lehangajanayake/formguard-booth/README.md

<p align="center">
  FormGuard
</p>

# FormGuard booth demo

FormGuard helps lifters understand their lifting form. Small motion sensors strapped to the arm stream to a web app that shows movement in 3D and surfaces elbow motion during bicep curls.

The standalone project site is in [`site/`](site/). [Watch the demo](https://formguard-booth-demo-report.vercel.app) to see the recorded booth sessions, hardware overview and custom sensor enclosure. The live sensor app remains in [`frontend/`](frontend/).

The booth videos are in `site/media/` as `clean-curl.mp4` and `elbow-swing.mp4`; the project page synchronizes them with the clean curl and swinging arm sensor recordings. Session recordings under `data/` are included in `site/recordings/` for replay and downloads.

To recalculate the video-to-sensor alignment, install `analysis/requirements.txt` with `uv pip install --python analysis/.venv/bin/python -r analysis/requirements.txt`, then run `analysis/.venv/bin/python analysis/sync_video_pose.py`. YOLO pose detection finds the clean clip's calibration gesture and curl cycles; clean playback starts at the third curl, aligned with the first sample in that recording. YOLO weights are cached outside the repository.

<p align="center">
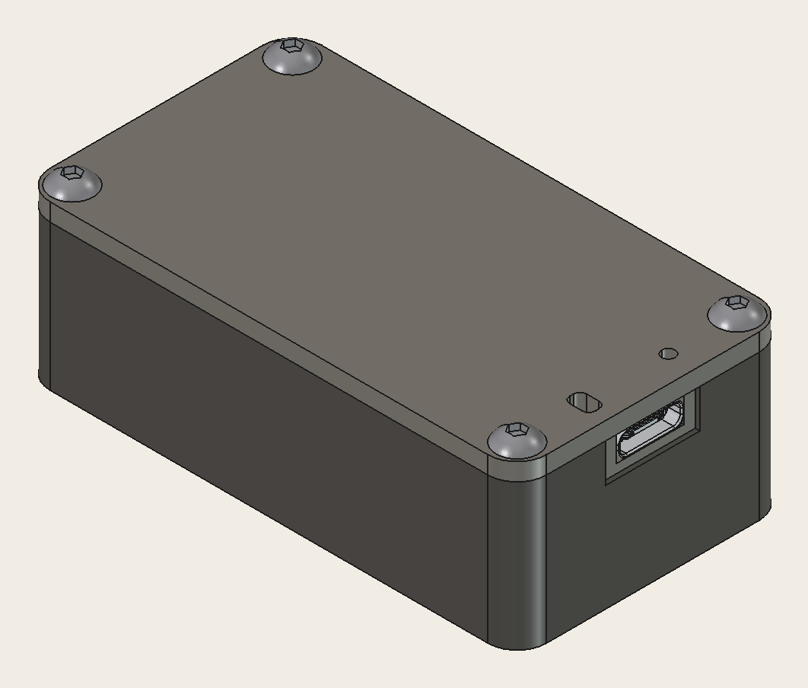
[picture p1: 3d-case/images/case_assembled.png]
The sensor case, assembled, with the USB-C port at the front
  
</p>

## How it works

1. Each sensor is a **Seeed XIAO nRF52840 Sense** with a 400 mAh LiPo, in a 3D-printed case. Its 6-axis IMU (LSM6DS3, accelerometer and gyro) feeds an orientation filter on the board at about 100 Hz.
2. The board sends its orientation over **Bluetooth LE**, as a quaternion, at about 50 Hz.
3. The **web app** connects with Web Bluetooth and turns those orientations into joint angles. It shows them on a 3D arm.

The app supports three sensor setups:

| Setup | Boards | What it measures |
| --- | --- | --- |
| Forearm only | 1 | Elbow angle and forearm twist |
| Wrist only | 1, worn like a watch | Elbow angle and forearm twist |
| Upper arm + forearm | 2 | Elbow angle, forearm twist and where the elbow drifts to |

## Repo layout

| Folder | What's in it |
| --- | --- |
| [`embedded/`](embedded) | Sensor firmware (PlatformIO, Arduino). Orientation filter, BLE service, calibrate and sleep commands, battery level |
| [`frontend/`](frontend) | Web app (Vite, three.js, Web Bluetooth) and the FormGuard design system |
| [`3d-case/`](3d-case) | The sensor case: FreeCAD script, print files and reference models |

## Getting started

### Flash the sensors

Install [PlatformIO](https://platformio.org/). Then, from `embedded/`:

```bash
pio run -e imu -t upload         # forearm or wrist board, advertises as FormGuard-Fore
pio run -e imu-upper -t upload   # upper arm board, advertises as FormGuard-Upper
```

### Run the web app

```bash
cd frontend
npm install
npm run dev
```

Open the address Vite prints to use the live sensor app. Web Bluetooth isn't supported in Safari or Firefox. Pick a sensor setup, strap the boards on as the app shows, and hold the calibration pose: arm hanging straight, palm facing your thigh.

### Build the static website

The project site is plain static HTML, CSS and JavaScript. Serve or deploy the contents of `site/` as a static website. Keep its `assets/`, `recordings/` and `media/` folders alongside `index.html`.

### Battery and sleep

Each board reports its battery over BLE: voltage, an estimated percentage for the 400 mAh LiPo, and whether it is charging over USB-C. The app shows it as a battery icon with the percentage inside. The Calibrate page shows it next to each sensor. The Live page shows it too, and warns at 20% or below, where the icon turns red.

**Sleep** (on the Calibrate page) or **Sleep sensors** (on the Live page) switches a board off, except the accelerometer. **Double-tap the board** to wake it, then press Connect. RESET also restarts a sleeping board, and double-pressing RESET still enters the UF2 bootloader for flashing.

## The sensor case

<p align="center">
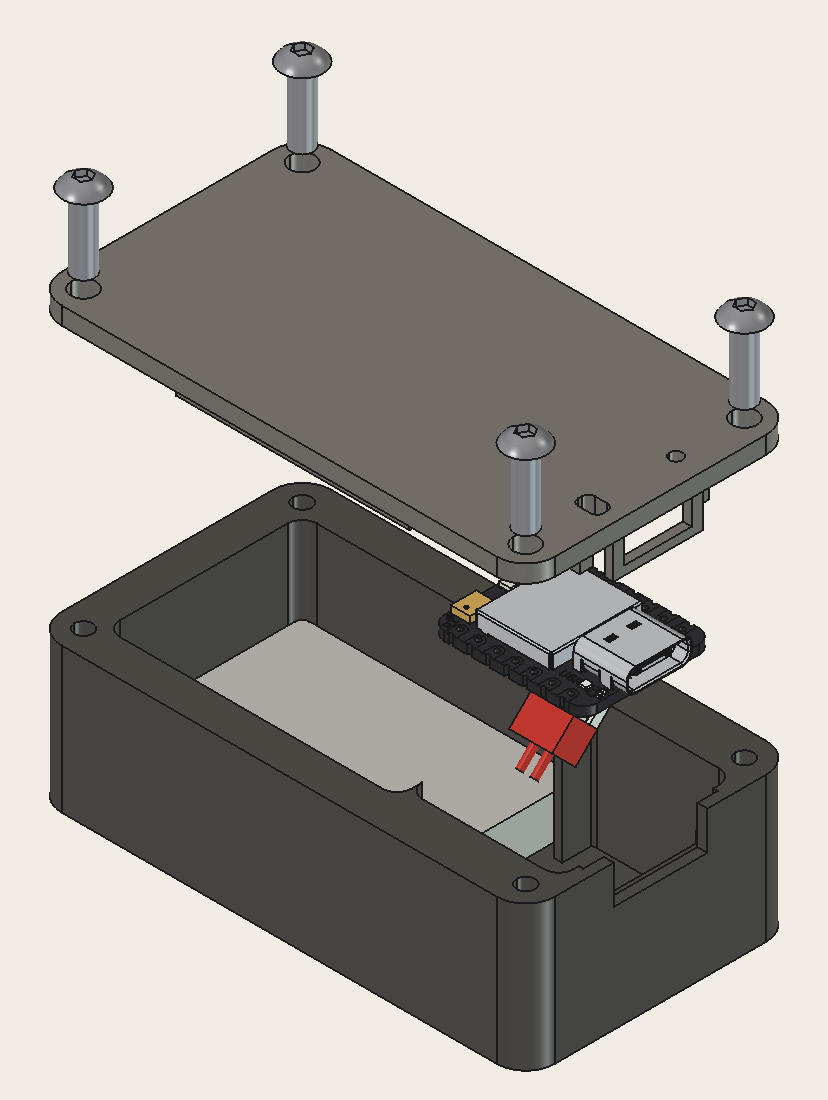
[picture p2: 3d-case/images/case_exploded.png]
Exploded view: base with the battery, board with the battery plug, lid and four screws
  
</p>

Two printed parts, a base and a lid, held together by four standard M3 × 10 screws, with no inserts or nuts. The outside is **67.7 × 37 × 22.3 mm**.

- **Battery beside the board.** The LiPo lies on the floor at the far end from the USB-C, clear of the board. Two ribs on the lid hold it down. The board's battery socket hangs into a pit underneath the board.
- **USB-C reachable from outside.** You can charge and flash without opening the case.
- **LED window and reset hole** in the lid.
- **Board clips into the lid.** The USB-C hooks into a cradle as a hinge, and a flexible latch clicks over the far end. No tape or tools, and it comes out the same way. With the lid on, the board's corners rest on four fins in the base.

<p align="center">
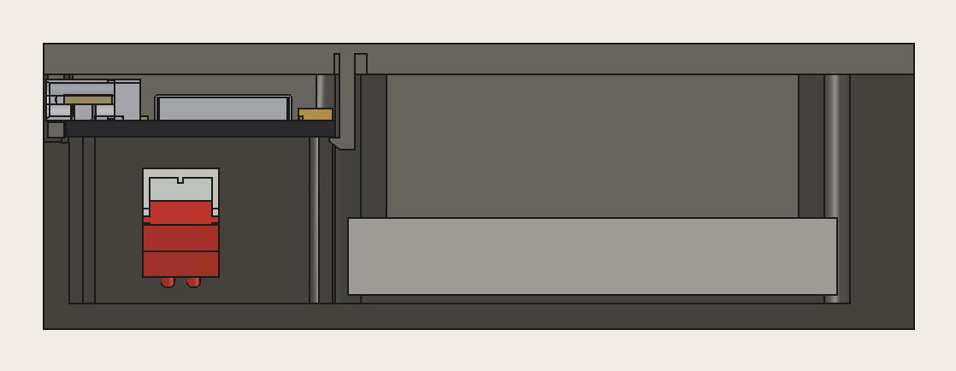
[picture p3: 3d-case/images/case_section.png]
Cut-away: the board under the lid, the battery socket and plug in the pit below it, and the battery beside it
  
</p>

<p align="center">
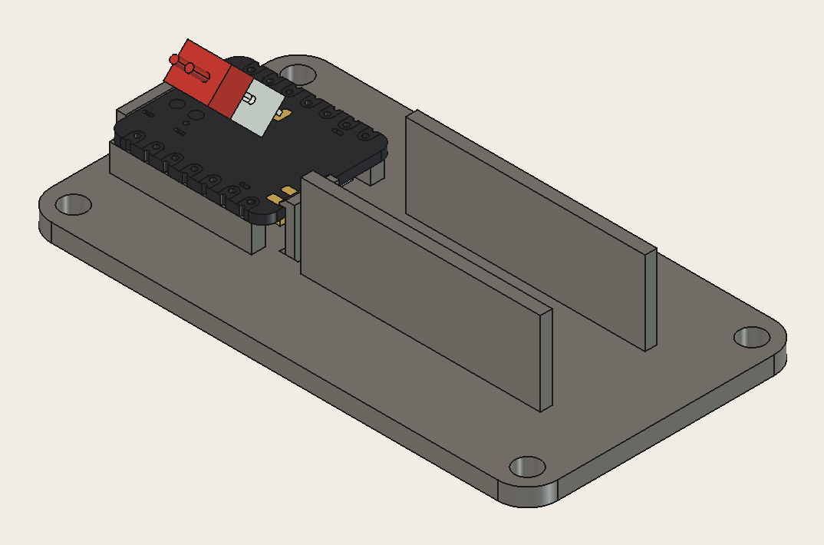
[picture p4: 3d-case/images/case_lid_board.png]
The lid upside down with the board clipped in
  
</p>

Print it in PETG. The lid's latch has to flex, and PLA may crack after many clicks. A PrusaSlicer project for the MK4S is in `3d-case/print-package/` and takes about 1 h 24 min and 28 g for the set, with no supports.

Dimensions, assembly, print settings and how to change the design are in [`3d-case/README.md`](3d-case/README.md).
