lehangajanayake/formguard-booth/3d-case/prompt.md

I want a case for seeed xio nrf 52 with a battery that will be soldered to it the inforamtion about the battery can be found on https://core-electronics.com.au/polymer-lithium-ion-battery-400mah-38456.html

I have no idea how to mount it since ethere are no cutouts for any screws as far as im aware, therefore u have creatice choise over it, I need a cutout to view the in built LED I should be able to get the board out to the casing when needed

Im using a 3rd party service to get this done, id like screws but only use standard screws if any,
