lehangajanayake/formguard-booth/frontend/FormGuard-design-system/previews/components.png

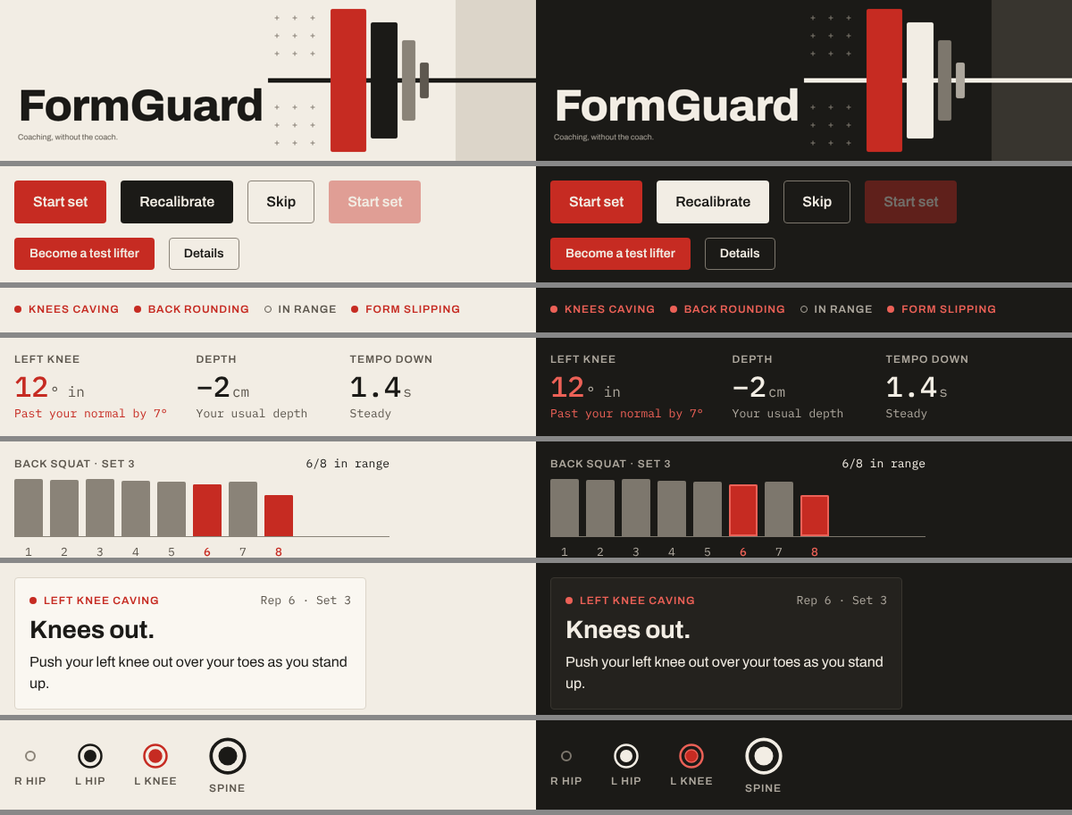
frontend/FormGuard-design-system/previews/components.png
