lehangajanayake/formguard-booth/3d-case/output/formguard_case.FCStd

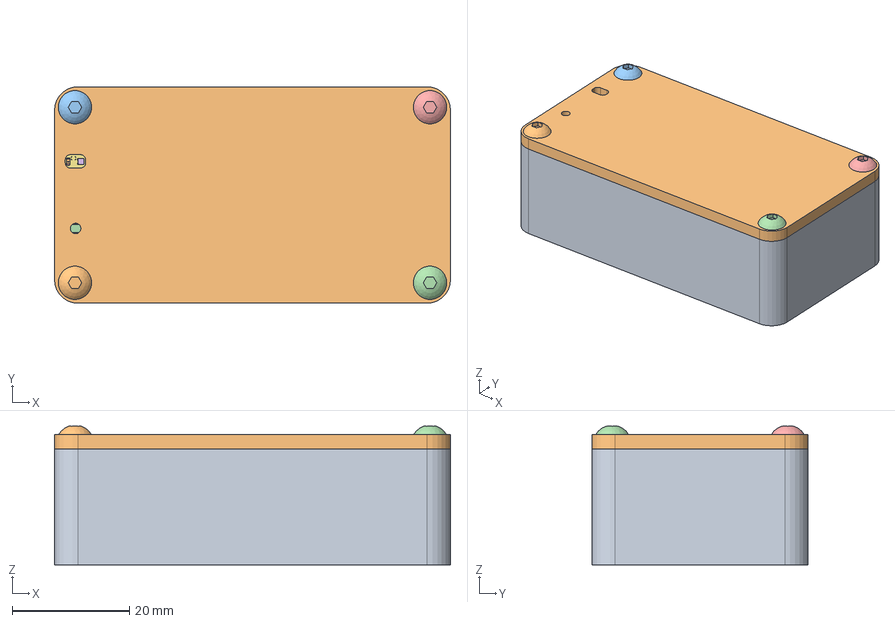
[picture p6: CAD file, 2026-10-20]
3d-case/output/formguard_case.FCStd
67.7 x 37.0 x 23.7 mm
Base
Lid
BOSS-EXTRUDE14_8_
BOSS-EXTRUDE7_4_
BOSS-EXTRUDE7_3_
BOSS-EXTRUDE14_4_
BOSS-EXTRUDE14_2_
BOSS-EXTRUDE14_11_
BOSS-EXTRUDE7_7_
BOSS-EXTRUDE14_9_
BOSS-EXTRUDE14_3_
BOSS-EXTRUDE14_7_
MIRROR2
BOSS-EXTRUDE14_5_
BOSS-EXTRUDE14_12_
BOSS-EXTRUDE7_8_
BOSS-EXTRUDE7_1_
BOSS-EXTRUDE14_10_
BOSS-EXTRUDE7_9_
BOSS-EXTRUDE14_6_
BOSS-EXTRUDE14_1_
BOSS-EXTRUDE7_6_
BOSS-EXTRUDE7_2_
CUT-EXTRUDE5
BOSS-EXTRUDE7_5_
Shield
Pins
Pins001
Pins002
Pins003
CAP
CAP001
CAP002
ANT1
ANT001
ANT002
Silkscreen
Silkscreen001
Silkscreen002
Silkscreen003
Silkscreen004
Silkscreen005
Silkscreen006
Silkscreen007
Silkscreen008
Silkscreen009
Silkscreen010
Silkscreen011
Silkscreen012
CAP004
CAP005
CAP006
CAP 3
CAP 001
CAP 002
LED
LED001
LED002
LED003
USR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
