lehangajanayake/formguard-booth/3d-case/print-package/formguard_base.step

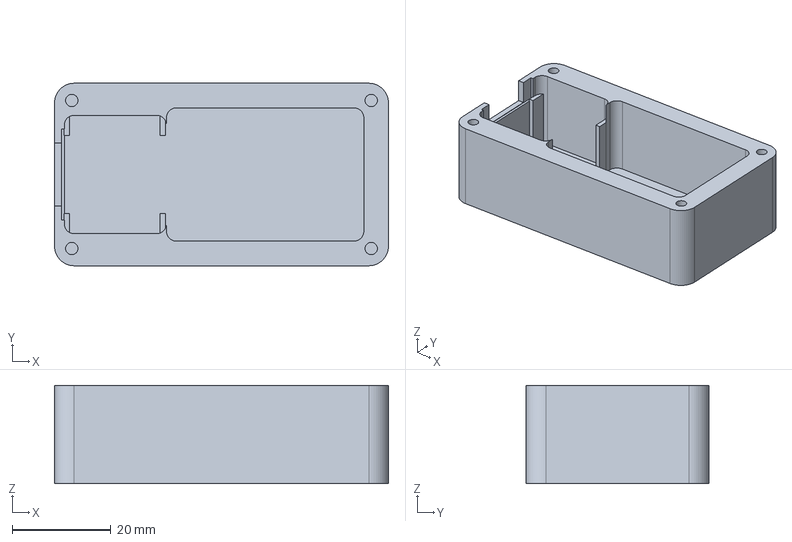
[picture p7: CAD file, 2026-10-20]
3d-case/print-package/formguard_base.step
67.7 x 37.0 x 19.9 mm
