lehangajanayake/formguard-booth/3d-case/reference/battery-400mah/battery_400mah.step

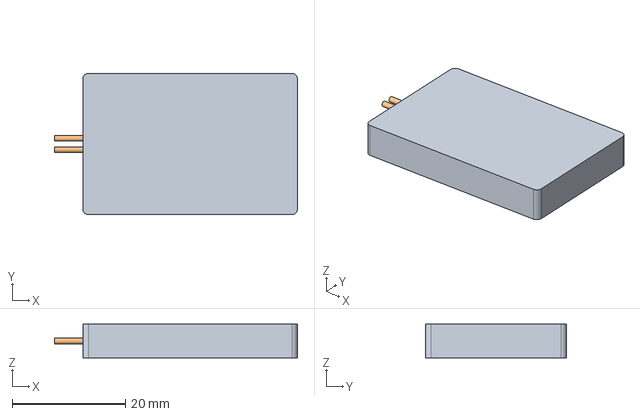
[picture p8: CAD file, 2026-10-20]
3d-case/reference/battery-400mah/battery_400mah.step
43.0 x 25.0 x 6.00 mm
