lehangajanayake/formguard-booth/3d-case/reference/jst-ph/PHR-2_mated_envelope.step

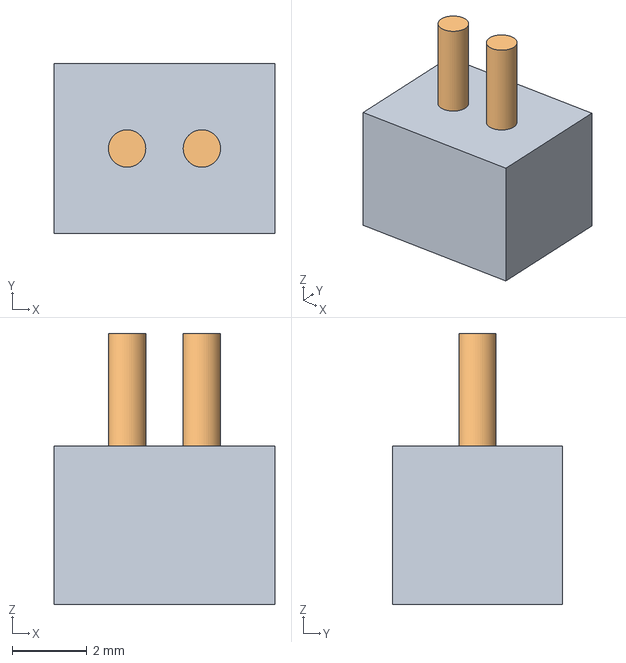
[picture p9: CAD file, 2026-10-20]
3d-case/reference/jst-ph/PHR-2_mated_envelope.step
5.90 x 4.55 x 7.24 mm
