lehangajanayake/formguard-booth/3d-case/reference/xiao-nrf52840/bottom-pad-positioning/Seeed XIAO nRF52840 v1.0 Dimensioning.dxf

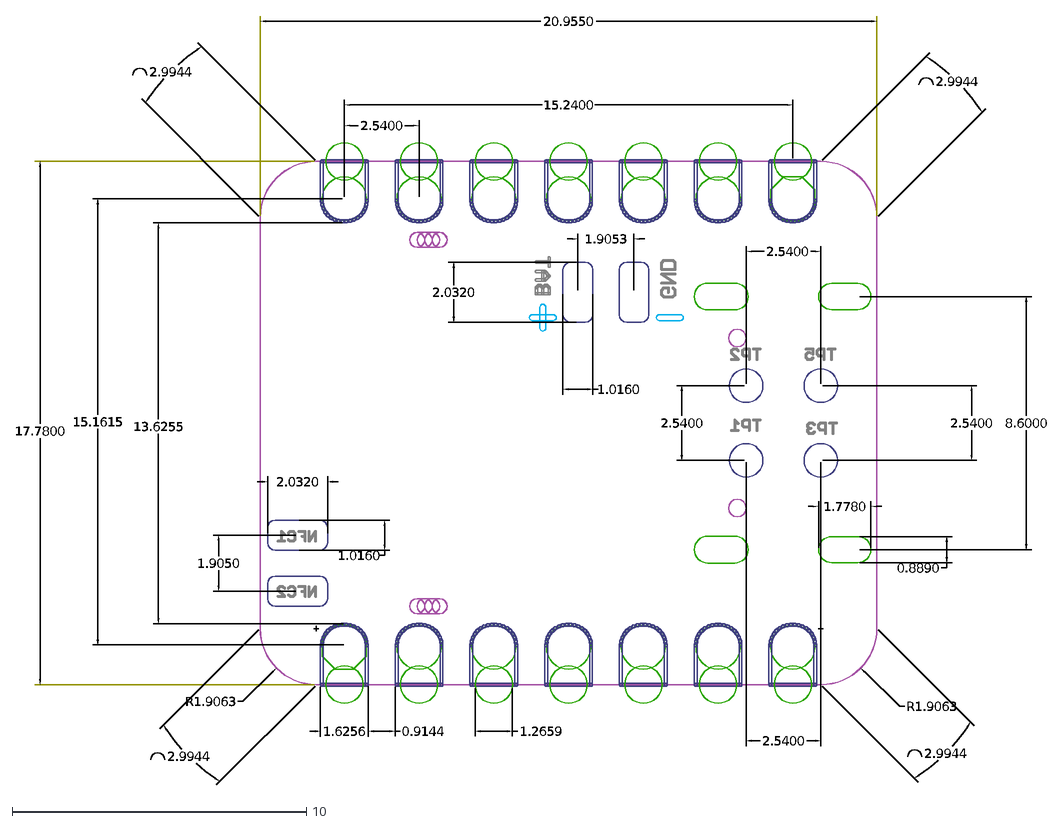
[picture p10: CAD file, 2026-10-19]
3d-case/reference/xiao-nrf52840/bottom-pad-positioning/Seeed XIAO nRF52840 v1.0 Dimensioning.dxf
20.9550
17.7800
15.2400
1.6256
2.5400
2.0320
1.0160
1.9053
1.9050
R1.9063
2.9944
0.9144
13.6255
8.6000
0.8890
1.7780
15.1615
1.2659
