lehangajanayake/formguard-booth/3d-case/output/formguard_lid.step

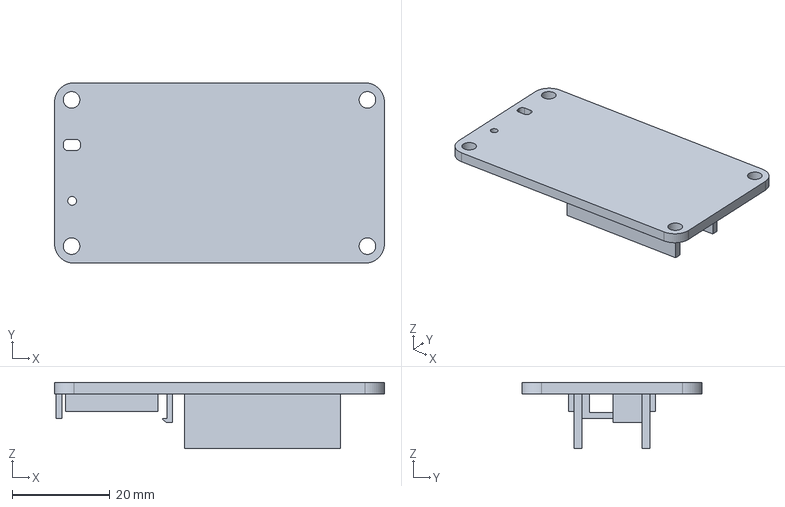
[picture p12: CAD file, 2026-10-20]
3d-case/output/formguard_lid.step
67.7 x 37.0 x 13.6 mm
