lehangajanayake/formguard-booth/3d-case/reference/jst-ph/JST_PH_B2B-PH-K_1x02_P2.00mm_Vertical.step

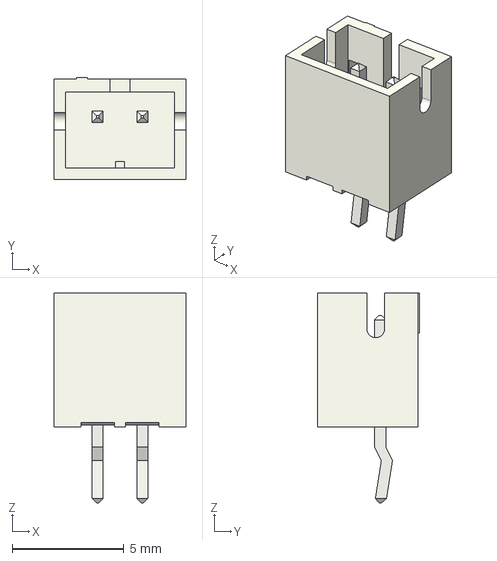
[picture p13: CAD file, 2026-10-20]
3d-case/reference/jst-ph/JST_PH_B2B-PH-K_1x02_P2.00mm_Vertical.step
5.90 x 4.55 x 9.40 mm
