lehangajanayake/formguard-booth/3d-case/reference/xiao-nrf52840/top.dxf

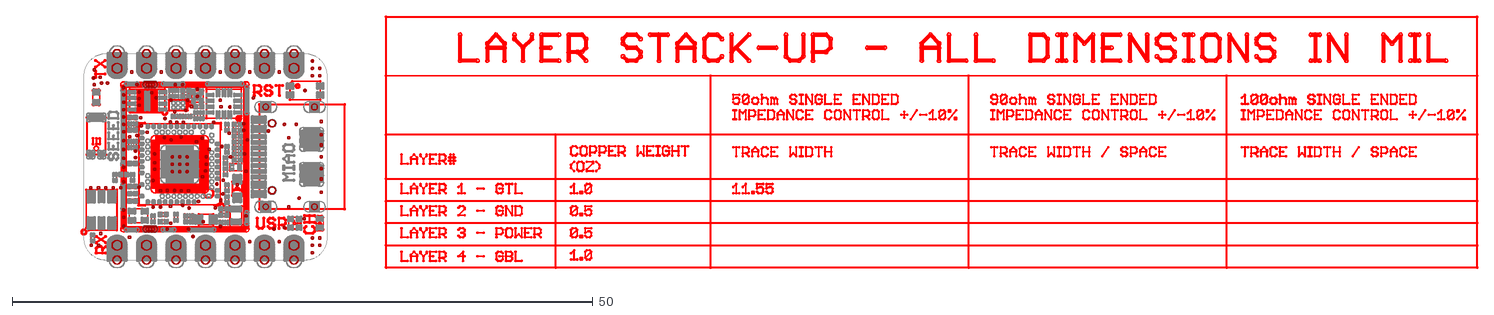
[picture p14: CAD file, 2026-10-19]
3d-case/reference/xiao-nrf52840/top.dxf
125.9 x 22.3
