lehangajanayake/formguard-booth/3d-case/print-package/formguard_case_MK4S_PETG.3mf

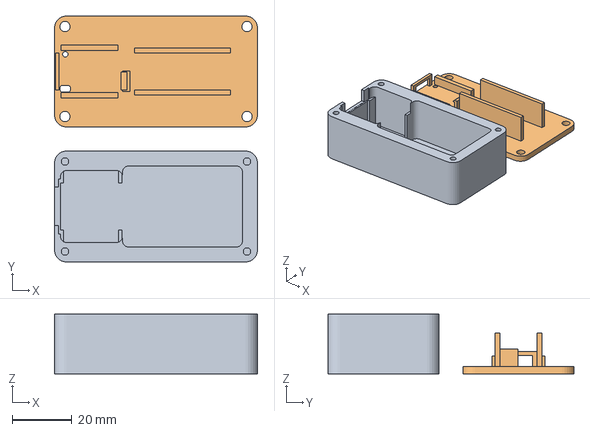
[picture p15: CAD file, 2026-10-20]
3d-case/print-package/formguard_case_MK4S_PETG.3mf
67.7 x 82.0 x 19.9 mm
base
lid
