lehangajanayake/formguard-booth/3d-case/reference/xiao-nrf52840/bottom.dxf

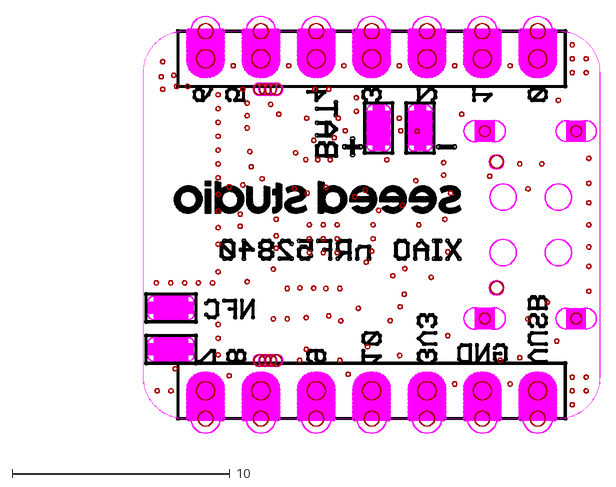
[picture p16: CAD file, 2026-10-19]
3d-case/reference/xiao-nrf52840/bottom.dxf
26.8 x 19.7
