lehangajanayake/formguard-booth/3d-case/reference/screws/ISO7380-1_M3x10.step

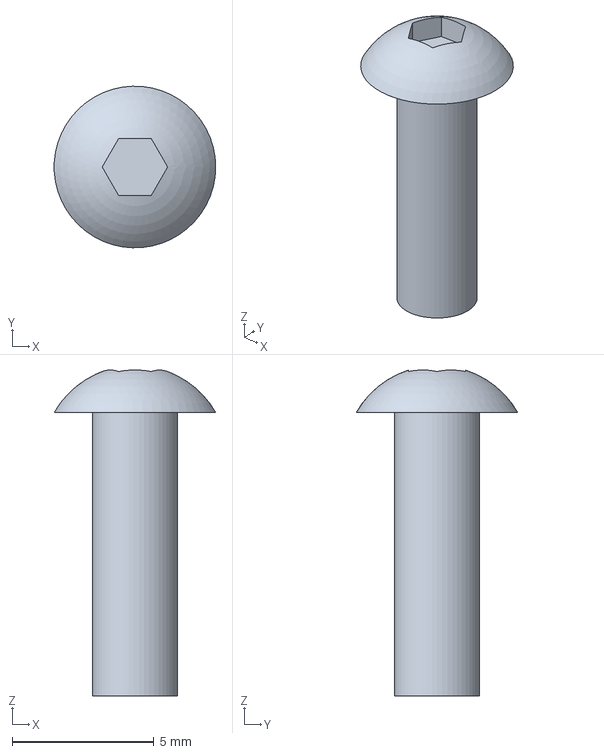
[picture p17: CAD file, 2026-10-20]
3d-case/reference/screws/ISO7380-1_M3x10.step
5.69 x 5.70 x 11.5 mm
