lehangajanayake/formguard-booth/(list of files, cad)

Other CAD files:
3d-case/output/formguard_base.stl
3d-case/output/formguard_lid.stl
3d-case/print-package/formguard_base.stl
3d-case/print-package/formguard_lid.stl
