lehangajanayake/formguard-booth/3d-case/print-package/preview_assembly.png

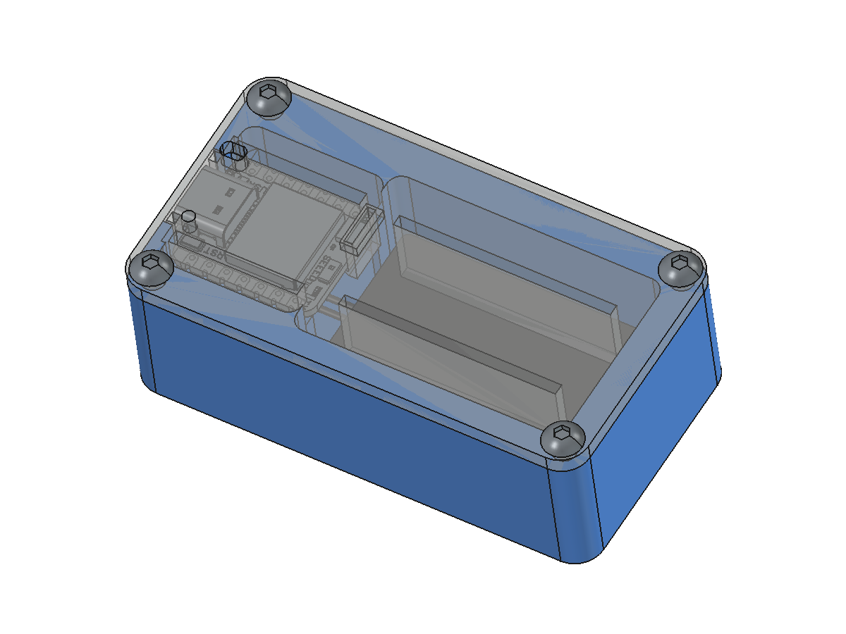
3d-case/print-package/preview_assembly.png
