lehangajanayake/formguard-booth/3d-case/print-package/preview_base.png

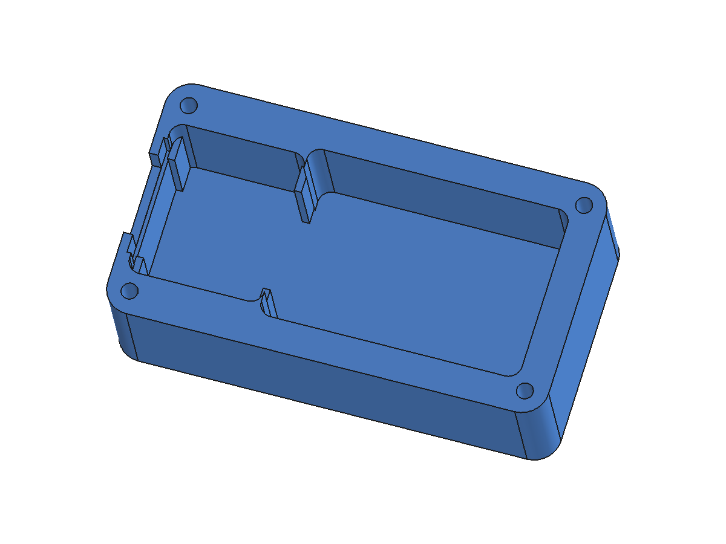
3d-case/print-package/preview_base.png
