lehangajanayake/formguard-booth/3d-case/print-package/preview_lid_underside.png

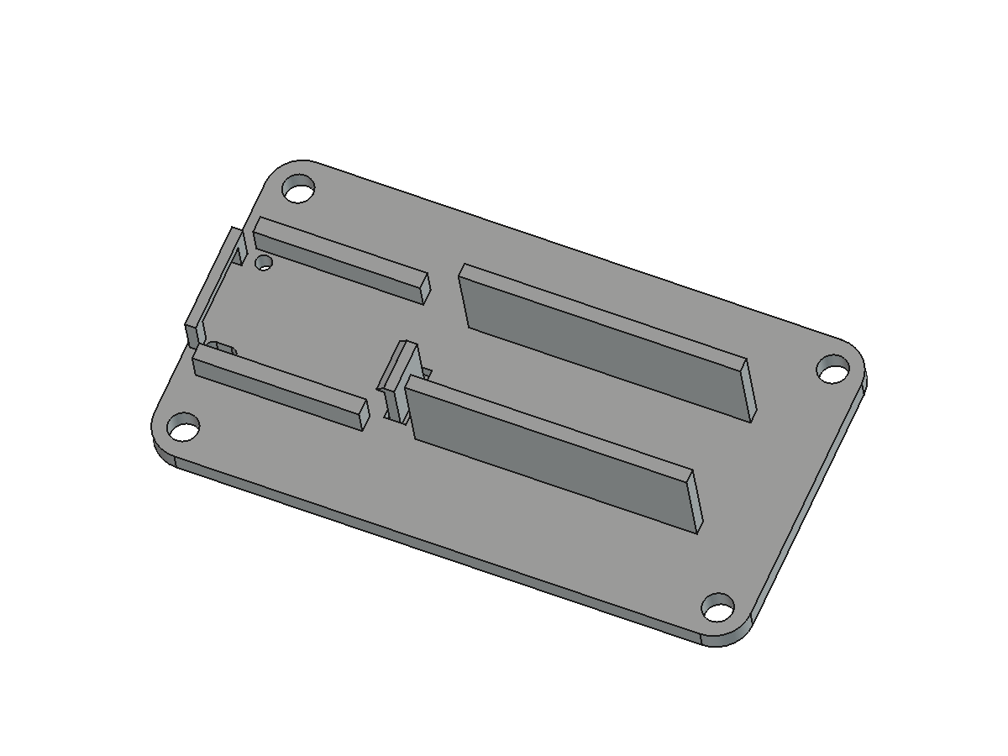
3d-case/print-package/preview_lid_underside.png
