lehangajanayake/formguard-booth/(commit log)

2026-10-19 Add FreeCAD MCP server config for 3d-case work
2026-10-19 Add XIAO nRF52840 and 400mAh LiPo reference files for case design
    [Seeed XIAO nRF52840 v1.0 Bottom Key coordinates .xls, Seeed XIAO nRF52840 v1.0 Dimensioning.dxf, XIAO-nRF52840.step, bottom.dxf, top.dxf]
2026-10-19 Add stacked 3-part FormGuard case (base, deck, lid) for XIAO nRF52840 + 400mAh LiPo
    Parametric FreeCAD script with STEP/STL exports, M2 heat-set insert fixings,
    USB-C slot, LED window and reset access hole.
    [formguard_base.step, formguard_base.stl, formguard_case.FCStd, formguard_deck.step, formguard_deck.stl, formguard_lid.step, formguard_lid.stl]
2026-10-19 Add taped lid pad over the XIAO RF shield to hold the board for the IMU
    [formguard_base.step, formguard_base.stl, formguard_case.FCStd, formguard_deck.step, formguard_deck.stl, formguard_lid.step, formguard_lid.stl]
2026-10-19 Show the XIAO's USB-C connector in the reference model
    The STEP's USB-C container was hidden by mistake as a stray duplicate.
    [formguard_base.step, formguard_case.FCStd, formguard_deck.step, formguard_lid.step]
2026-10-19 Add print package: brief, STL/STEP, previews and zip for the print service
    [formguard_base.step, formguard_base.stl, formguard_deck.step, formguard_deck.stl, formguard_lid.step, formguard_lid.stl]
2026-10-19 Switch case fixings to 8x M2x8 screws threading into printed pilot holes
    Drops heat-set inserts: 4 screws hold base to deck from underneath, 4 hold
    the lid to the deck. Updates README, print brief, previews and print package.
    [formguard_base.step, formguard_base.stl, formguard_case.FCStd, formguard_deck.step, formguard_deck.stl, formguard_lid.step, formguard_lid.stl]
2026-10-19 Switch case fixings to 4x M3x15 screws threading into the base
    Heads sit on the lid (an M3 counterbore would break out of the corners);
    2.5 mm pilot holes in the base give ~6.5 mm of thread. Updates README,
    print brief, previews and print package.
    [formguard_base.step, formguard_base.stl, formguard_case.FCStd, formguard_deck.step, formguard_deck.stl, formguard_lid.step, formguard_lid.stl]
2026-10-19 Widen lid clamp ribs to 1.9 mm so they print as 4-5 solid FDM lines
    [formguard_base.step, formguard_case.FCStd, formguard_deck.step, formguard_lid.step, formguard_lid.stl]
2026-10-20 Add imu-upper PlatformIO env for the upper arm board
    Same firmware as imu, built with DEVICE_NAME "FormGuard-Upper" so the
    frontend can tell the two boards apart.
2026-10-20 Implement the upper arm + forearm sensor setup in the frontend
    Elbow flexion and forearm twist come from the forearm board's rotation
    relative to the upper arm board, so shoulder movement no longer reads as
    elbow flexion. The boards' heading offset is measured at calibration from
    their face normals (both strapped flat on the outer side of the arm).
    - SensorRig bundles the links and estimator for a setup so the calibrate
    and live pages handle one or two boards alike
    - SensorLink can limit the device chooser to a board name
    - Quaternion helpers move to orientation-math.js; ForearmEstimator output
    is unchanged
2026-10-20 Track elbow position from gravity, correct heading drift, left arm model
    The boards are 6-DoF, so heading drifts. The upper arm pose now comes
    from gravity alone: the model's upper arm swings to where the elbow is
    (forward/back and out/in) and ignores turning about the vertical. The
    live page shows it as an "Upper arm" reading for spotting elbow drift.
    Elbow flexion and twist still compare the two boards' full orientations,
    so the heading offset between them is now corrected continuously from
    the elbow being a hinge: once it bends, any sideways lean of the forearm
    out of the upper arm's forward plane is heading error.
    The model is mirrored into a left arm, and a floor disc under it gives
    t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
2026-10-20 Redesign case: battery beside the board, board clips into the lid
    - Battery sits beside the board at the far end from the USB-C, clear of it.
    The connector pit under the board is sized from the measured 11 mm drop
    of the 45 deg JST PH socket with plug and wires, plus 2 mm spare.
    - The board clips to the lid's underside: the USB-C hooks into a cradle
    (the hinge) and a flexible latch snaps under the far edge, off-centre
    to clear the chip antenna. No tape.
    - Reference models: KiCad JST PH socket STEP; battery, mated plug envelope
    and ISO 7380 M3 screw built from published dimensions by
    reference/make_reference_models.py. The build places them in the case
    and checks part-to-part an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
    [ISO7380-1_M3x15.step, JST_PH_B2B-PH-K_1x02_P2.00mm_Vertical.step, PHR-2_mated_envelope.step, battery_400mah.step, formguard_base.step, formguard_base.stl, formguard_case.FCStd, formguard_case_MK4S_PETG.3mf]
2026-10-20 Add a main README with renders of the sensor case
    The README covers what the booth demo is, how the sensors and web app fit
    together, how to flash the boards and run the app, and the case, with
    renders. 3d-case/render_images.py makes the renders in FreeCAD, so they
    can be regenerated after design changes.
2026-10-20 Drop the deck: two-part case with the board on fins and the battery on the floor
    The board clips into the lid, so the deck's pocket was no longer locating it.
    The deck's other jobs move as follows:
    - The base walls now go up to the lid, with the USB-C slot cut into them.
    - Four 1.1 x 1 mm fins rise from the pit floor under the board's corners.
    They sit clear of the socket glue, socket and plug, and the lid ribs clamp
    the board onto them.
    - The battery lies on foam on the floor, which removes the solid block under
    it. Two lid ribs press it 0.3 mm into the foam.
    The screws drop to M3 x 10, since they now pass only through the lid
    (7.6 mm of thread in the base). The fit check is clean ap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
    [ISO7380-1_M3x10.step, formguard_base.step, formguard_base.stl, formguard_case.FCStd, formguard_case_MK4S_PETG.3mf, formguard_deck.step, formguard_deck.stl, formguard_lid.step]
2026-10-21 Add bicep curl form check: rep counting and elbow swing
    The live page counts curl reps and flags elbow swing (the upper arm moving
    forward or back during a rep) for the upper arm + forearm setup, with a status
    flag, a cue card and a rep strip. Single-sensor setups show an error instead,
    since only the upper arm board knows where the elbow is. Thresholds live in
    sensor-config.js.
2026-10-21 Add recording, arm-raise calibration for either arm, and demo tweaks
    - Record button on the Live page: one label per recording, saves every raw
    packet from both boards plus the calibration packets and what the app
    derived per sample (angles, rep phase, swing, rep events) as JSON.
    - Calibration adds a straight-arm raise after the still pose. It measures
    forward and the heading between the two boards directly, so it no longer
    assumes a left arm or which way round the boards are strapped. A Left/Right
    arm choice mirrors the 3D arm and sets which side is "out".
    - Forearm rotation is no longer shown (it rotated the wrong way on a mirrored
    right arm); it is still estimated and recorded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
2026-10-21 Add Streamlit app for analysing booth recordings
    Loads the Live page's recording files, shows the app's angles, rep bands and
    board speeds over time, compares reps across recordings for any measure, and
    sweeps thresholds. Reps are found again by a Python port of the JS rep
    detector, so the sidebar shows what other thresholds would have flagged.
2026-10-21 Add BLE sleep command, double-tap wake and battery level
    Firmware: CMD_SLEEP (0x02) drops the connection, arms the accelerometer's
    double-tap interrupt on INT1 and enters System OFF; a double-tap reboots
    the board. New battery characteristic (...0004, read + notify every 2 s):
    u16 mV, u8 estimated percent for the 400 mAh LiPo, u8 flags (USB, charging).
    Charging current set to 100 mA.
    Web app: battery shown per sensor on Calibrate and in the Live meta line,
    low-battery warning at 15%, Sleep buttons on both pages, and an "asleep,
    double-tap to wake" state for a board put to sleep.
    [main.cpp]
2026-10-21 Show battery as an icon with the percent inside, red at 20%
    Replaces the battery text on the Calibrate rows and the Live meta line with
    a battery outline whose fill tracks the charge and which carries the number.
    It turns signal red at 20% or below, and a bolt follows it while charging.
    The Live low-battery warning now also triggers at 20%.
2026-10-22 Remove landing page arm illustration
